shinchan1907/rpmloop-navigator/docs/screenshots/02_home_page1.png

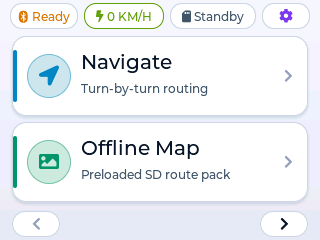
docs/screenshots/02_home_page1.png
