shinchan1907/rpmloop-navigator/docs/screenshots/03_home_page2.png

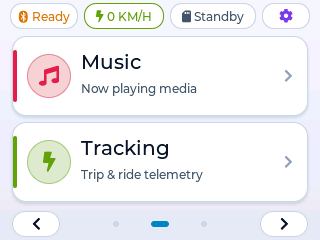
docs/screenshots/03_home_page2.png
