shinchan1907/rpmloop-navigator/docs/screenshots/04_home_page3.png

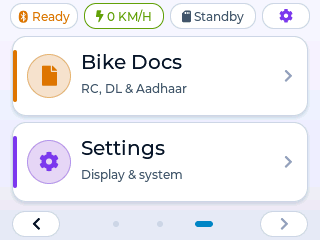
docs/screenshots/04_home_page3.png
