shinchan1907/rpmloop-navigator/docs/screenshots/05_bike_docs_hub.png

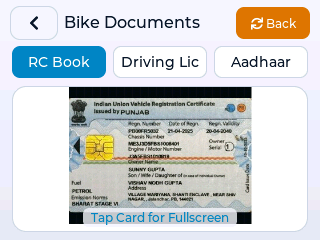
docs/screenshots/05_bike_docs_hub.png
