shinchan1907/rpmloop-navigator/docs/screenshots/06_rc_fullscreen.png

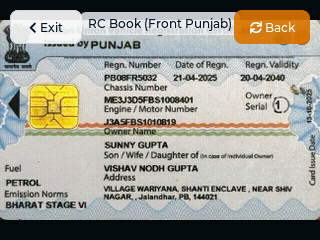
docs/screenshots/06_rc_fullscreen.png
