shinchan1907/rpmloop-navigator/docs/screenshots/07_rc_back_fullscreen.png

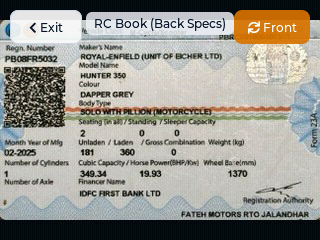
docs/screenshots/07_rc_back_fullscreen.png
