shinchan1907/rpmloop-navigator/docs/screenshots/08_aadhaar_fullscreen.png

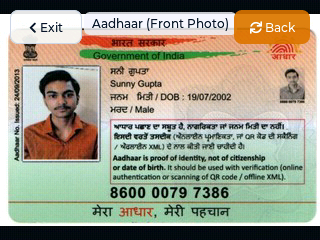
docs/screenshots/08_aadhaar_fullscreen.png
