shinchan1907/rpmloop-navigator/docs/screenshots/09_settings.png

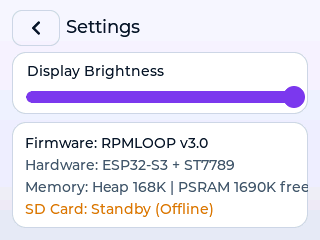
docs/screenshots/09_settings.png
