shinchan1907/rpmloop-navigator/printing_files/parts_and_hardware.csv

part | quantity | file | material | colour | layer_mm | walls | infill | thickness_notes | status
housing | 1 | 01_Rigid_STL/housing_qty1.stl | ASA | matte black | 0.20 | 6 | 35% gyroid, solid mount modifier | 3 mm walls; 4.5 mm seal lands; 3 mm fork fingers | FIT_TEST_ONLY
front_bezel | 1 | 01_Rigid_STL/front_bezel_qty1.stl | ASA | matte black | 0.16-0.20 | 5 | 35% | 4 mm plate | FIT_TEST_ONLY
rear_lid | 1 | 01_Rigid_STL/rear_lid_qty1.stl | ASA | matte black | 0.20 | 5 | 35% | 3 mm plate | FIT_TEST_ONLY
esp32_cradle | 1 | 01_Rigid_STL/esp32_cradle_qty1.stl | ASA | matte black | 0.16 | 4 | 100% | 1.6 mm base; provisional 1.4 mm slide groove | FIT_TEST_ONLY
PCB_tab_left | 2 | 01_Rigid_STL/PCB_tab_left_qty2.stl | ASA | matte black | 0.16-0.20 | 4 | 100% | 2 mm | FIT_TEST_ONLY
PCB_tab_right | 2 | 01_Rigid_STL/PCB_tab_right_qty2.stl | ASA | matte black | 0.16-0.20 | 4 | 100% | 2 mm | FIT_TEST_ONLY
insert_test_coupon | 1 | 01_Rigid_STL/insert_test_coupon_qty1.stl | ASA, same process as housing | matte black | 0.20 | 5 | 100% | 7 mm; four blind pilot trials | FIT_TEST_ONLY
joint_gasket | 2 | 02_Flexible_Prototype_STL/joint_gasket_qty2.stl | Silicone 40-50A preferred; TPU85A fit prototype | black | 0.10-0.15 for TPU | solid | 100% | 1.5 mm uncompressed, 1.3 mm ring width | FIT_TEST_ONLY
display_gasket | 1 | 02_Flexible_Prototype_STL/display_gasket_qty1.stl | Silicone; TPU85A template only | black | 0.10-0.15 for TPU | solid | 100% | 0.8 mm UNVERIFIED | FIT_TEST_ONLY
USB_cap_gasket | 1 | 02_Flexible_Prototype_STL/USB_cap_gasket_qty1.stl | Silicone; TPU85A optional template | black | 0.10-0.15 for TPU | solid | 100% | 1.0 mm; cap not designed | FIT_TEST_ONLY
M2_sealing_washer | 8 | 02_Flexible_Prototype_STL/M2_sealing_washer_qty8.stl | Purchased silicone preferred; TPU85A prototype | black | 0.10 for TPU | solid | 100% | 0.5 mm uncompressed | FIT_TEST_ONLY
M2x4 brass inserts | 14 | PURCHASE | metal | as supplied |  |  |  | Outside diameter and pilot UNVERIFIED | VERIFY_HARDWARE
M2x6 front screw candidates | 4 | PURCHASE | metal | as supplied |  |  |  | Verify head/washer/engagement | VERIFY_HARDWARE
M2x5 screw candidates | 10 | PURCHASE | metal | as supplied |  |  |  | 4 rear + 4 tabs + 2 cradle; verify actual hardware | VERIFY_HARDWARE
M5 thumb screw and mating nut receiver | 1 | PURCHASE | metal | as supplied |  |  |  | Knob opposite USB; actual mount UNVERIFIED | VERIFY_HARDWARE
