shinchan1907/rpmloop-navigator/printing_files/04_CAD/rpmloop_Hunter350_P3_assembly.step

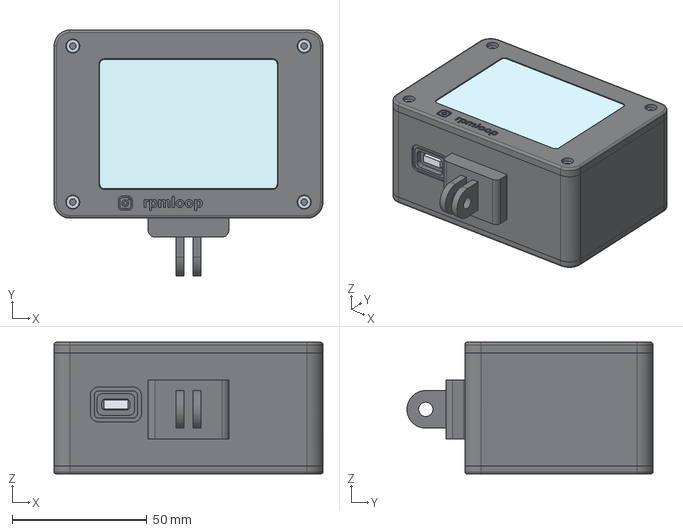
[picture p17: CAD file, 2026-10-26]
printing_files/04_CAD/rpmloop_Hunter350_P3_assembly.step
100.0 x 91.5 x 49.0 mm
