shinchan1907/rpmloop-navigator/printing_files/01_Rigid_STL/front_bezel_qty1.stl

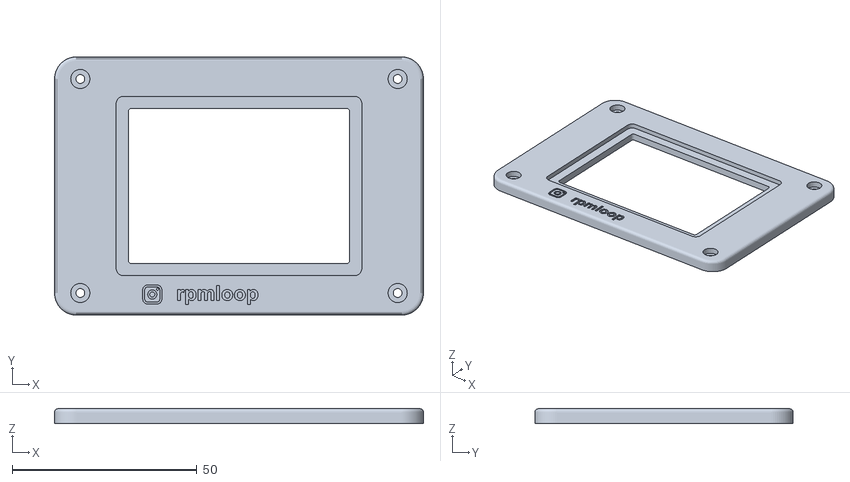
[picture p18: CAD file, 2026-10-26]
printing_files/01_Rigid_STL/front_bezel_qty1.stl
100.0 x 70.0 x 4.00
