shinchan1907/rpmloop-navigator/printing_files/02_Flexible_Prototype_STL/display_gasket_qty1.stl

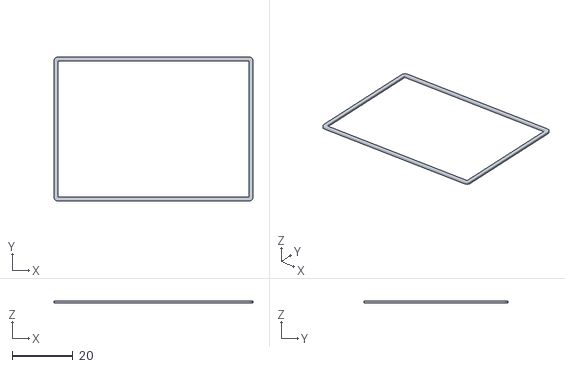
[picture p19: CAD file, 2026-10-26]
printing_files/02_Flexible_Prototype_STL/display_gasket_qty1.stl
65.4 x 47.4 x 0.8
