shinchan1907/rpmloop-navigator/printing_files/04_CAD/housing.step

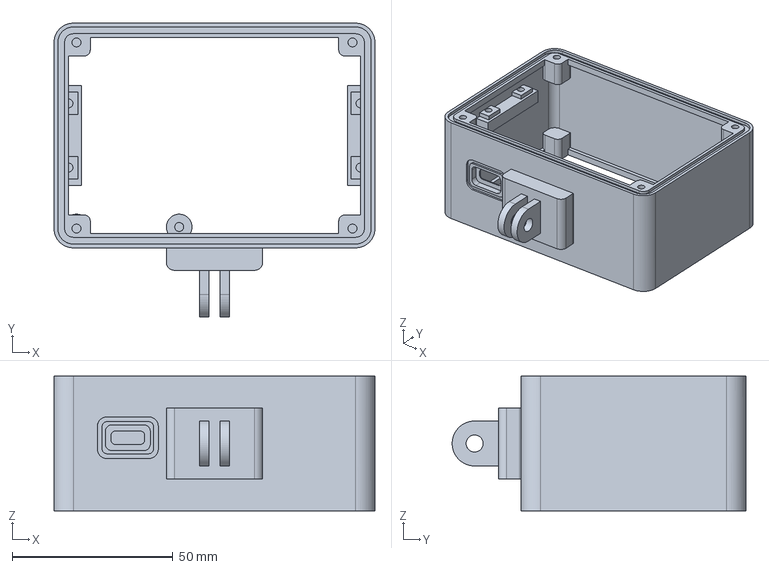
[picture p20: CAD file, 2026-10-26]
printing_files/04_CAD/housing.step
100.0 x 91.5 x 42.0 mm
