shinchan1907/rpmloop-navigator/printing_files/01_Rigid_STL/PCB_tab_right_qty2.stl

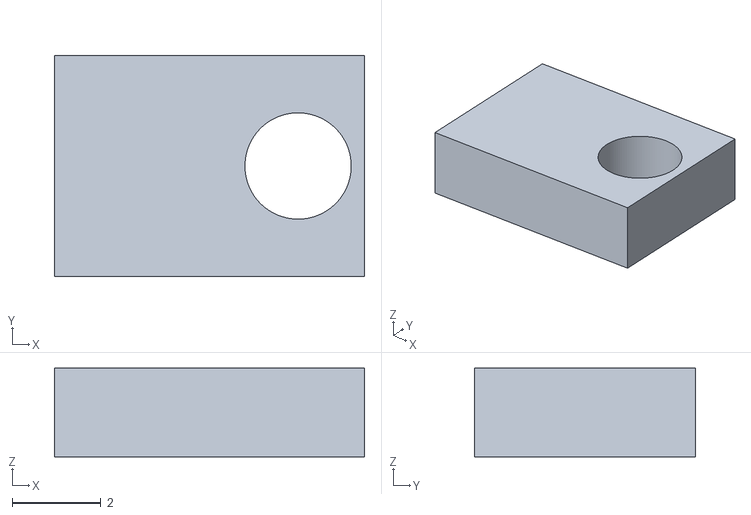
[picture p21: CAD file, 2026-10-26]
printing_files/01_Rigid_STL/PCB_tab_right_qty2.stl
7.00 x 5.00 x 2.00
