shinchan1907/rpmloop-navigator/printing_files/02_Flexible_Prototype_STL/joint_gasket_qty2.stl

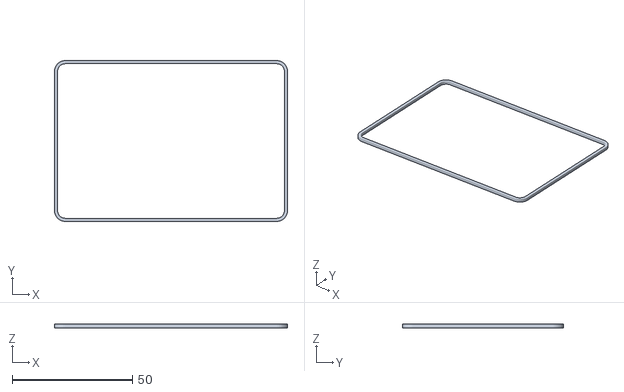
[picture p22: CAD file, 2026-10-26]
printing_files/02_Flexible_Prototype_STL/joint_gasket_qty2.stl
96.8 x 66.8 x 1.50
