shinchan1907/rpmloop-navigator/printing_files/04_CAD/esp32_cradle.step

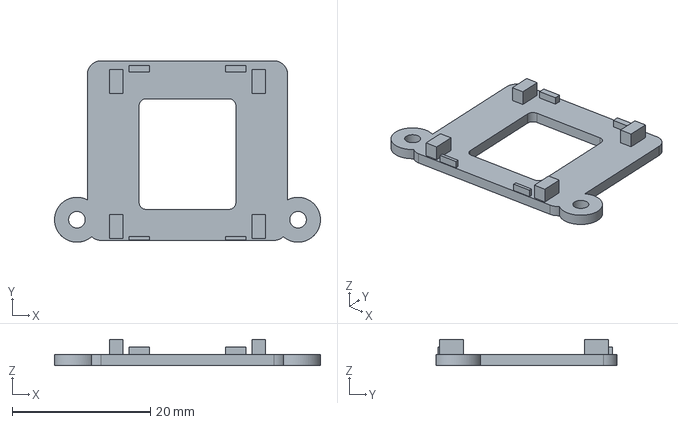
[picture p23: CAD file, 2026-10-26]
printing_files/04_CAD/esp32_cradle.step
38.5 x 26.2 x 3.80 mm
