shinchan1907/rpmloop-navigator/printing_files/01_Rigid_STL/rear_lid_qty1.stl

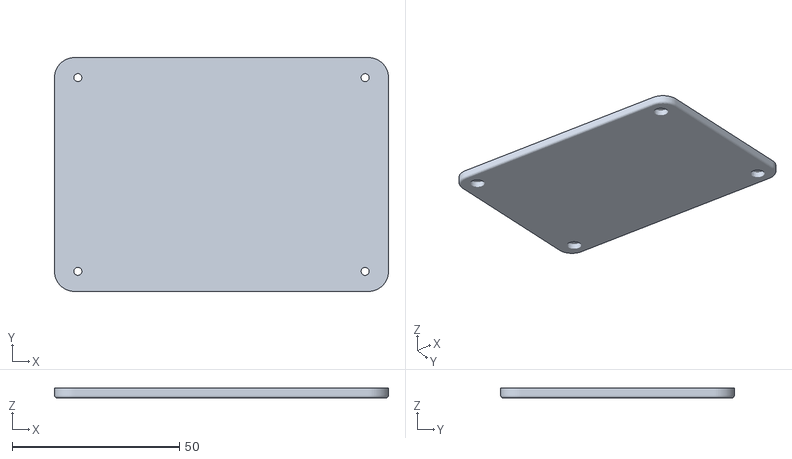
[picture p24: CAD file, 2026-10-26]
printing_files/01_Rigid_STL/rear_lid_qty1.stl
100.0 x 70.0 x 3.00
