shinchan1907/rpmloop-navigator/printing_files/02_Flexible_Prototype_STL/USB_cap_gasket_qty1.stl

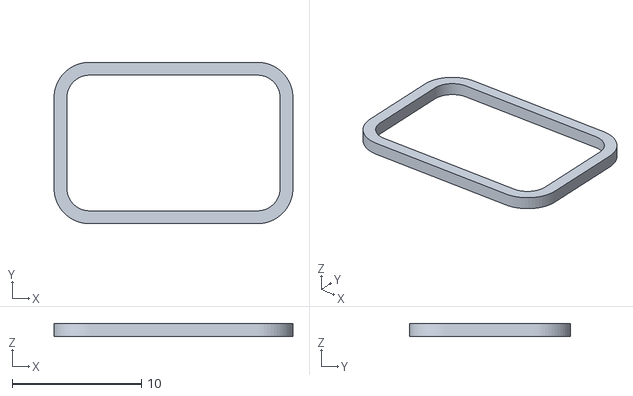
[picture p25: CAD file, 2026-10-26]
printing_files/02_Flexible_Prototype_STL/USB_cap_gasket_qty1.stl
18.5 x 12.5 x 1.00
