shinchan1907/rpmloop-navigator/printing_files/01_Rigid_STL/insert_test_coupon_qty1.stl

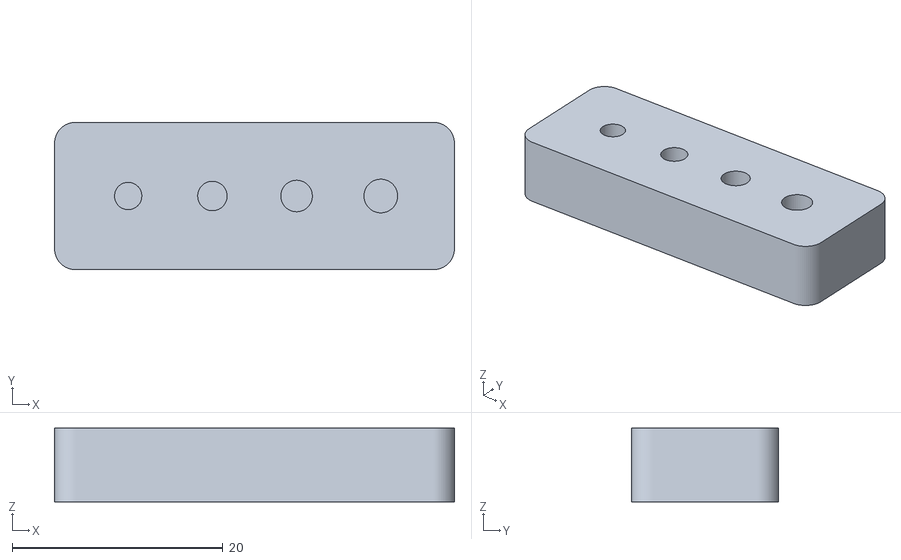
[picture p26: CAD file, 2026-10-26]
printing_files/01_Rigid_STL/insert_test_coupon_qty1.stl
38.0 x 14.0 x 7.00
