shinchan1907/rpmloop-navigator/(list of files, cad)

Other CAD files:
printing_files/01_Rigid_STL/PCB_tab_left_qty2.stl
printing_files/04_CAD/PCB_tab_right.step
printing_files/04_CAD/rear_lid.step
printing_files/04_CAD/front_bezel.step
printing_files/01_Rigid_STL/esp32_cradle_qty1.stl
printing_files/04_CAD/display_gasket.step
printing_files/01_Rigid_STL/housing_qty1.stl
printing_files/04_CAD/PCB_tab_left.step
printing_files/04_CAD/joint_gasket.step
printing_files/04_CAD/insert_test_coupon.step
printing_files/04_CAD/USB_cap_gasket.step
printing_files/02_Flexible_Prototype_STL/M2_sealing_washer_qty8.stl
printing_files/04_CAD/M2_sealing_washer.step
