shinchan1907/rpmloop-navigator/printing_files/03_Images/assembly.png

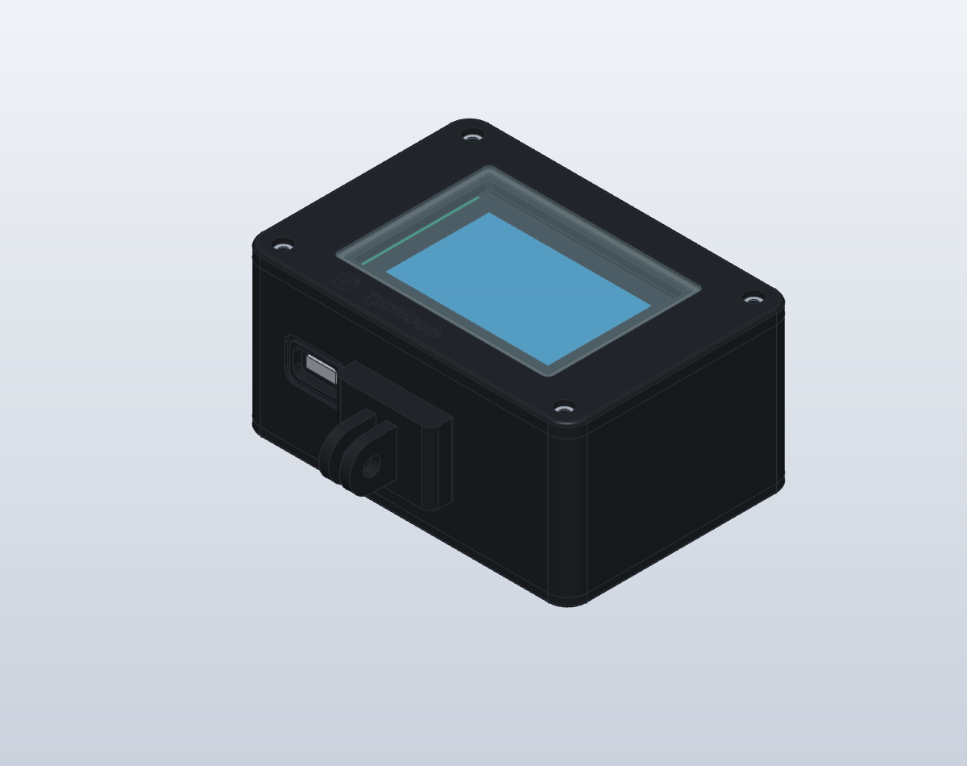
printing_files/03_Images/assembly.png
