shinchan1907/rpmloop-navigator/printing_files/03_Images/bottom_USB_and_two_fingers.png

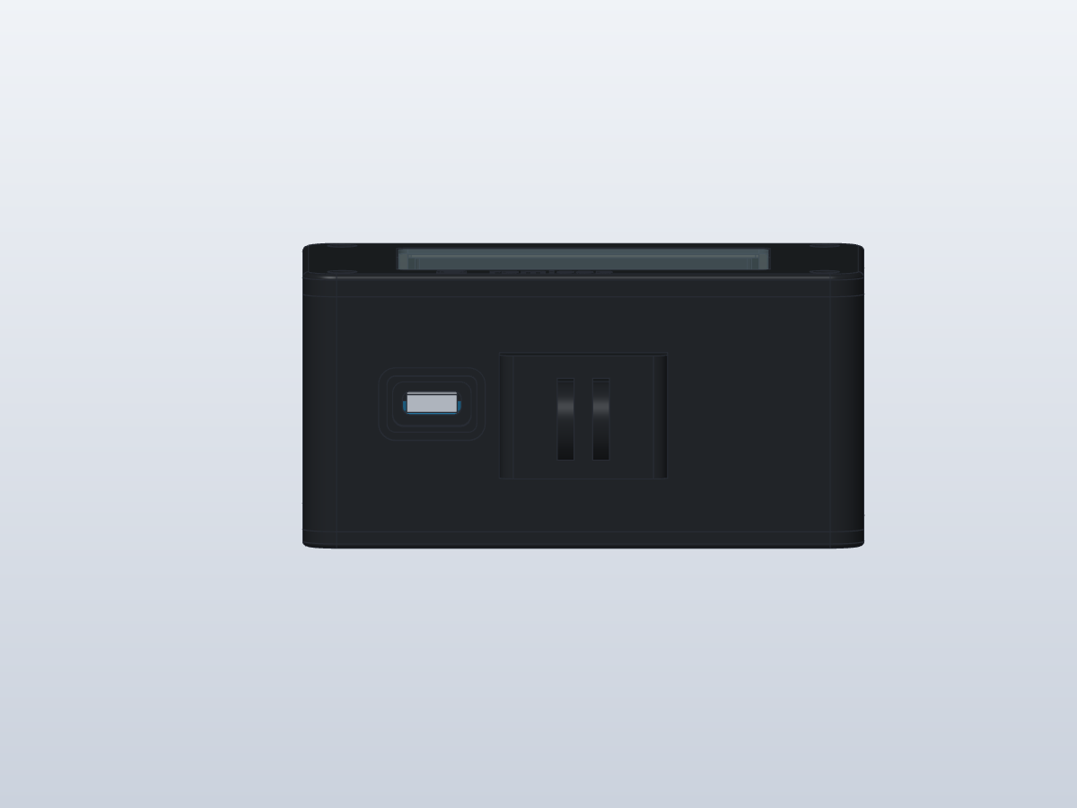
printing_files/03_Images/bottom_USB_and_two_fingers.png
