shinchan1907/rpmloop-navigator/printing_files/03_Images/display_gasket.png

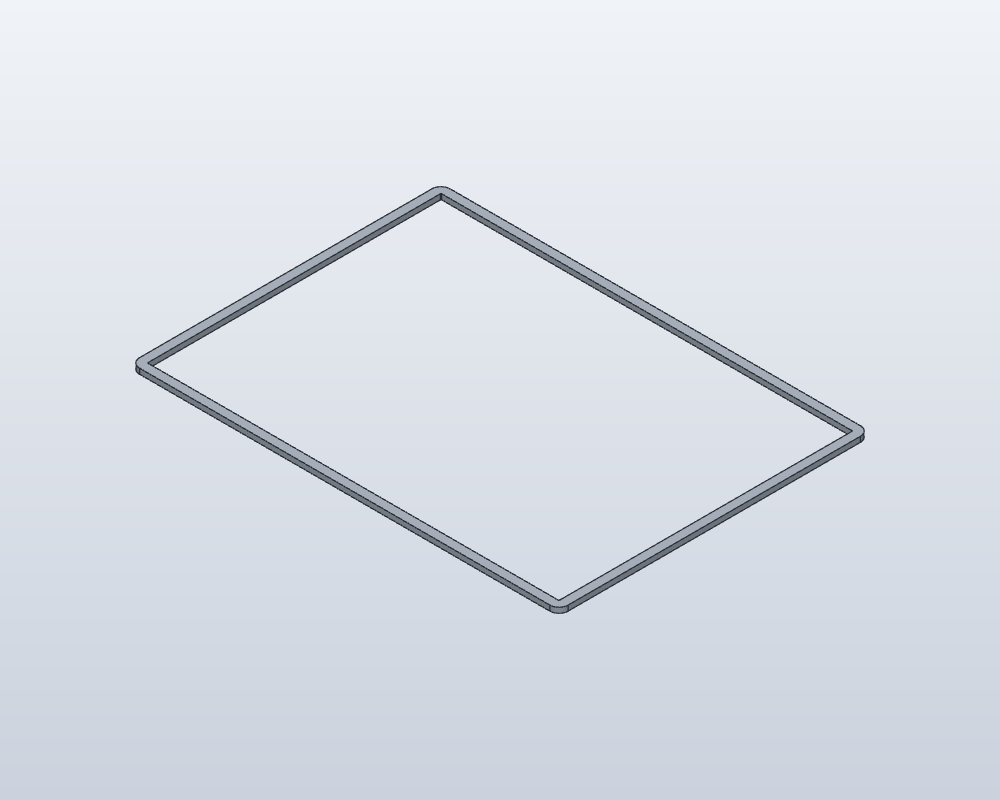
printing_files/03_Images/display_gasket.png
