shinchan1907/rpmloop-navigator/printing_files/03_Images/esp32_cradle.png

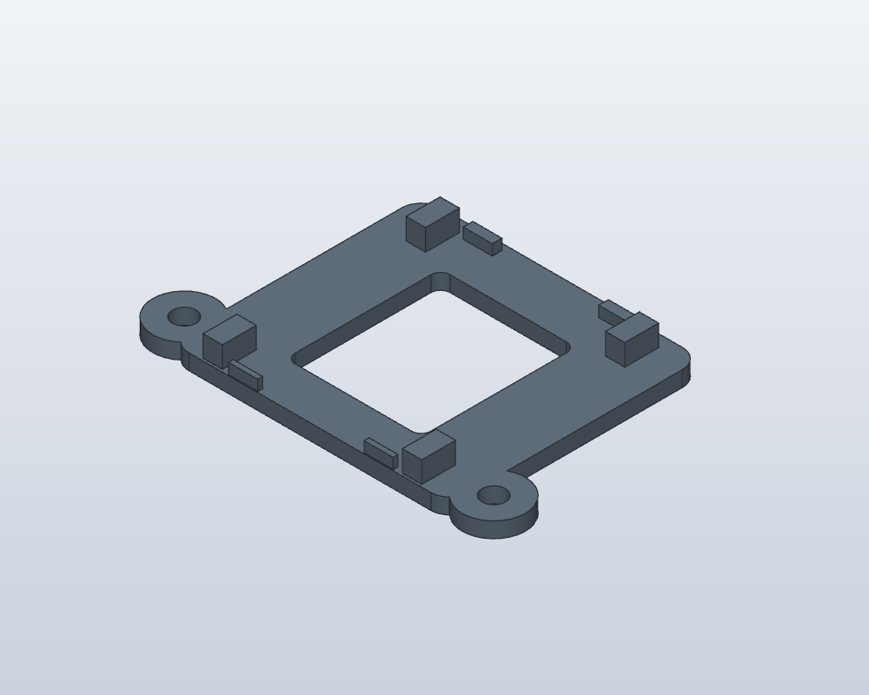
printing_files/03_Images/esp32_cradle.png
