shinchan1907/rpmloop-navigator/printing_files/03_Images/front_bezel.png

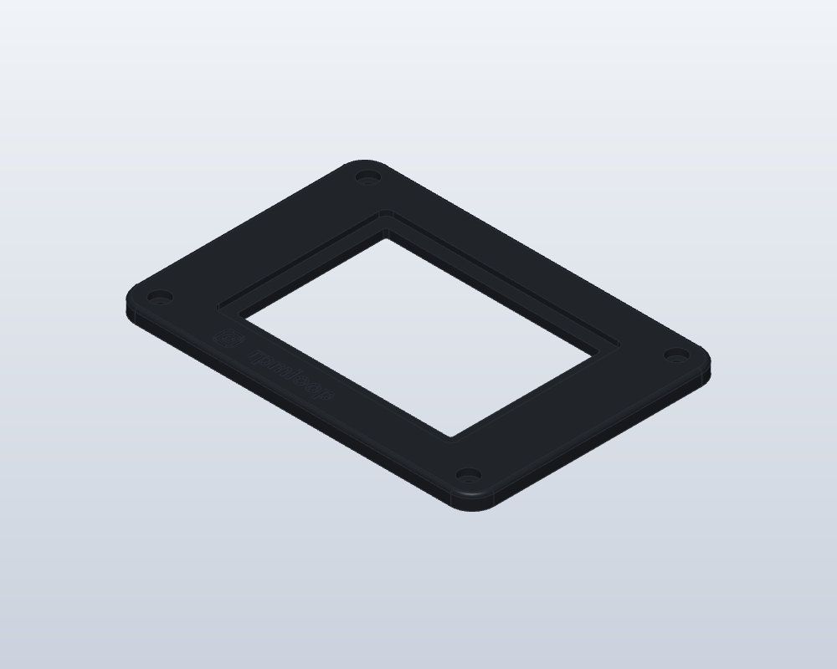
printing_files/03_Images/front_bezel.png
