shinchan1907/rpmloop-navigator/printing_files/03_Images/housing.png

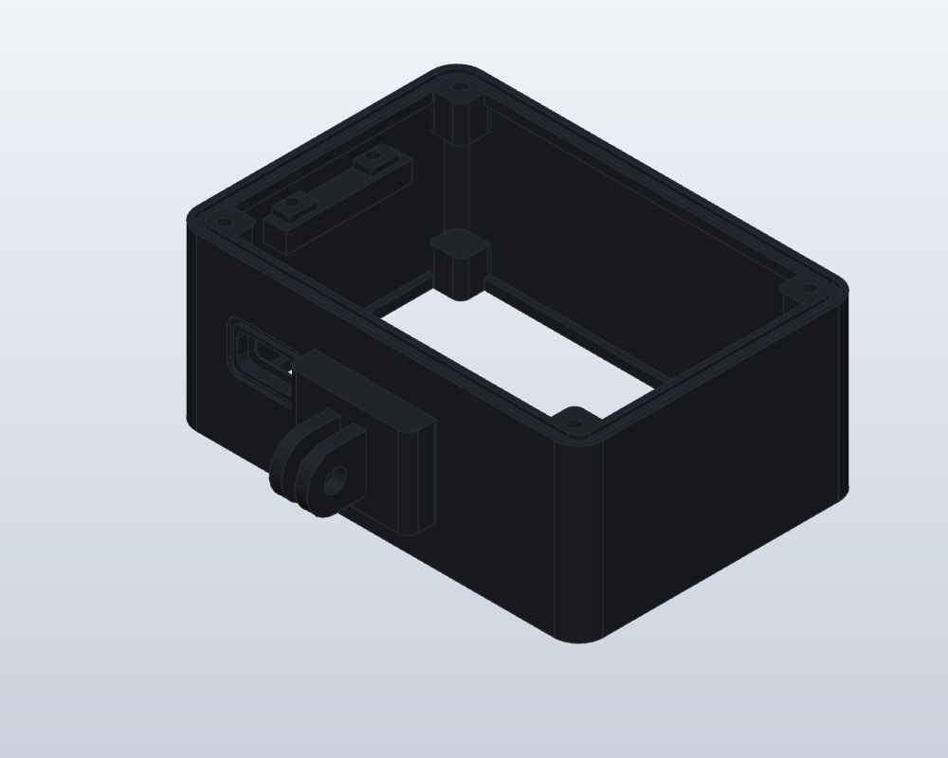
printing_files/03_Images/housing.png
