shinchan1907/rpmloop-navigator/printing_files/03_Images/internal_holders_and_groove.png

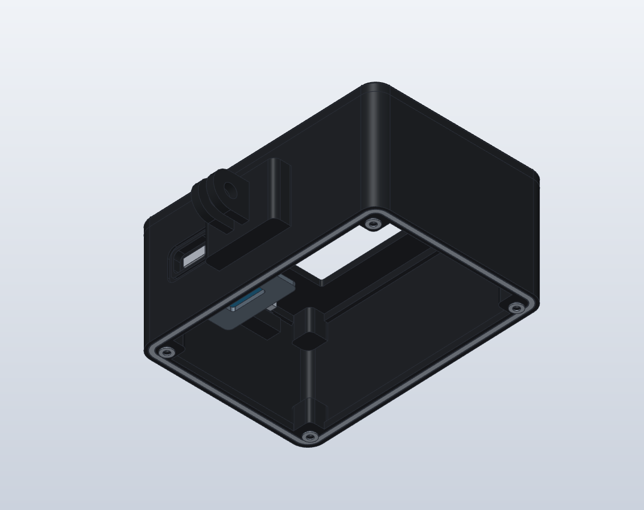
printing_files/03_Images/internal_holders_and_groove.png
