shinchan1907/rpmloop-navigator/printing_files/03_Images/M2_sealing_washer.png

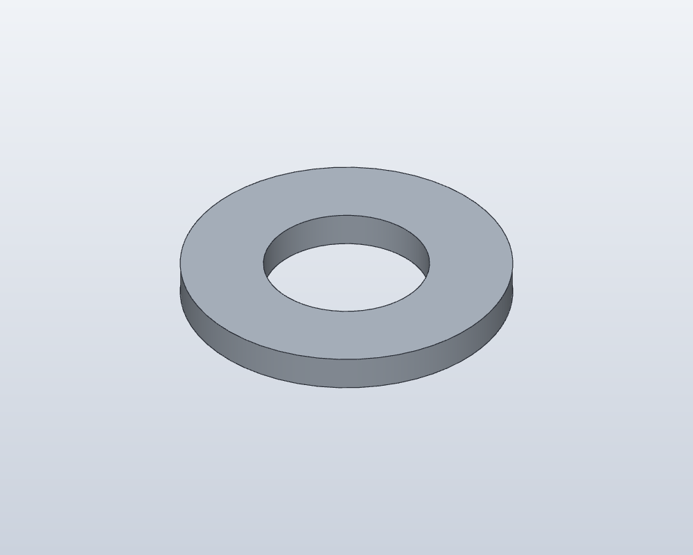
printing_files/03_Images/M2_sealing_washer.png
