shinchan1907/rpmloop-navigator/printing_files/03_Images/PCB_tab_left.png

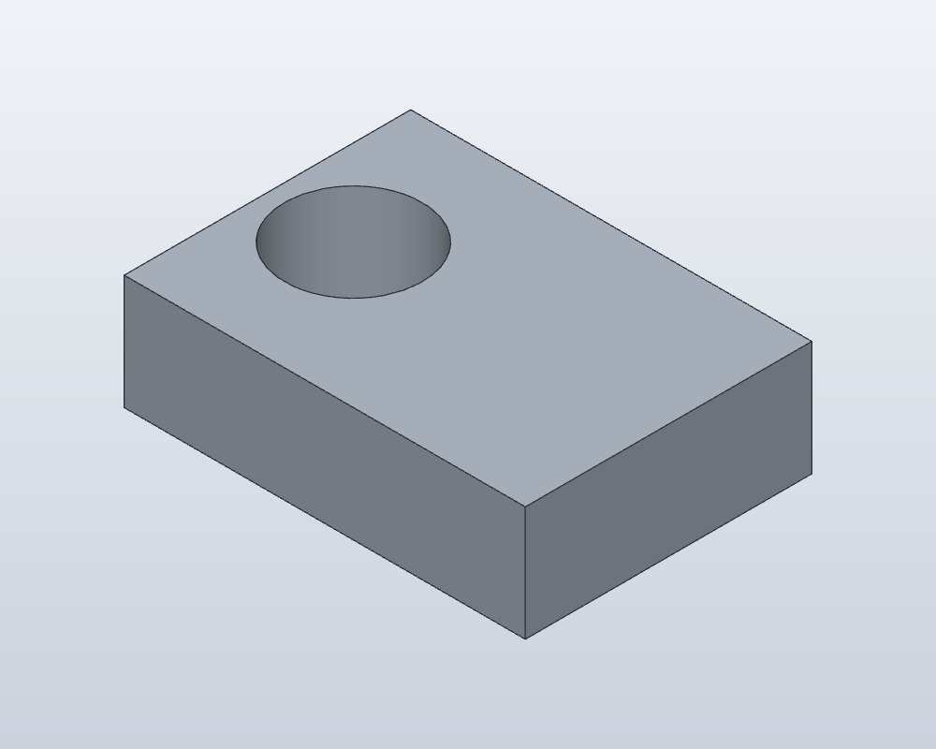
printing_files/03_Images/PCB_tab_left.png
