shinchan1907/rpmloop-navigator/printing_files/03_Images/PCB_tab_right.png

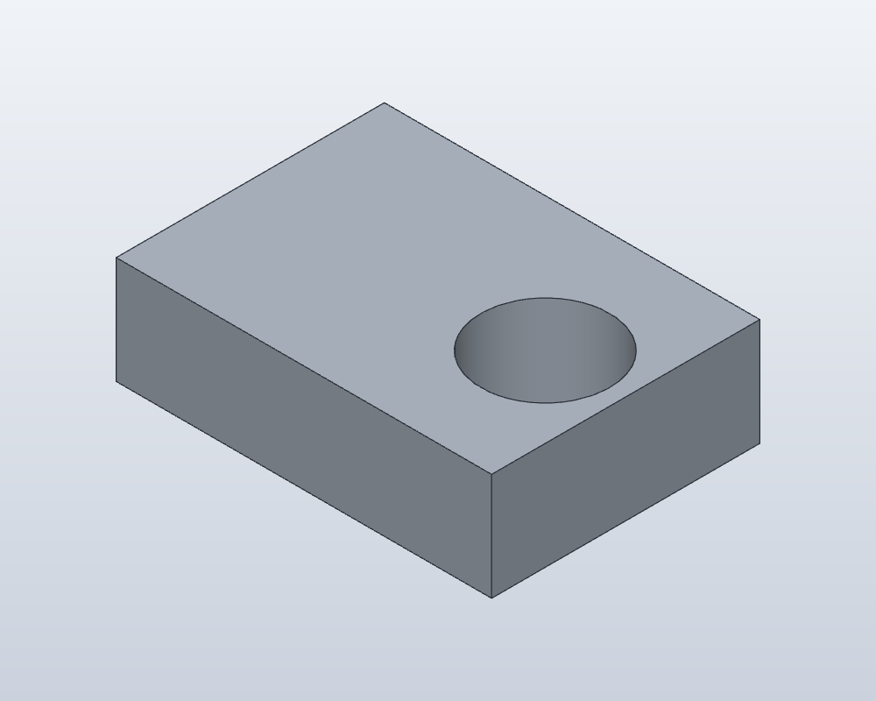
printing_files/03_Images/PCB_tab_right.png
