shinchan1907/rpmloop-navigator/printing_files/03_Images/rear_lid.png

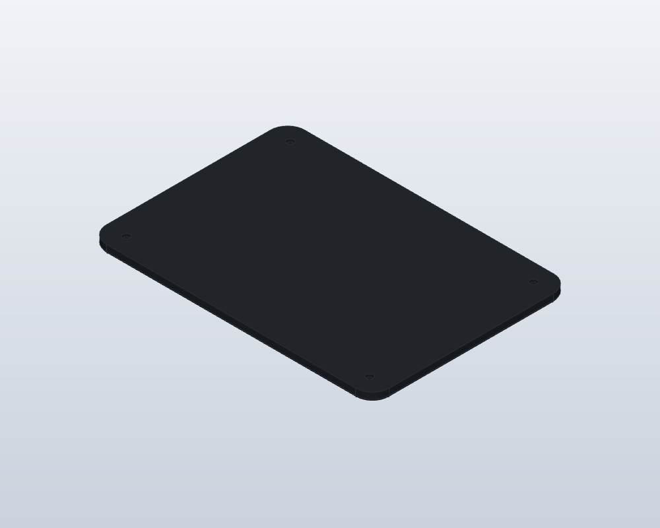
printing_files/03_Images/rear_lid.png
