shinchan1907/rpmloop-navigator/printing_files/03_Images/TOP_RPMLOOP.png

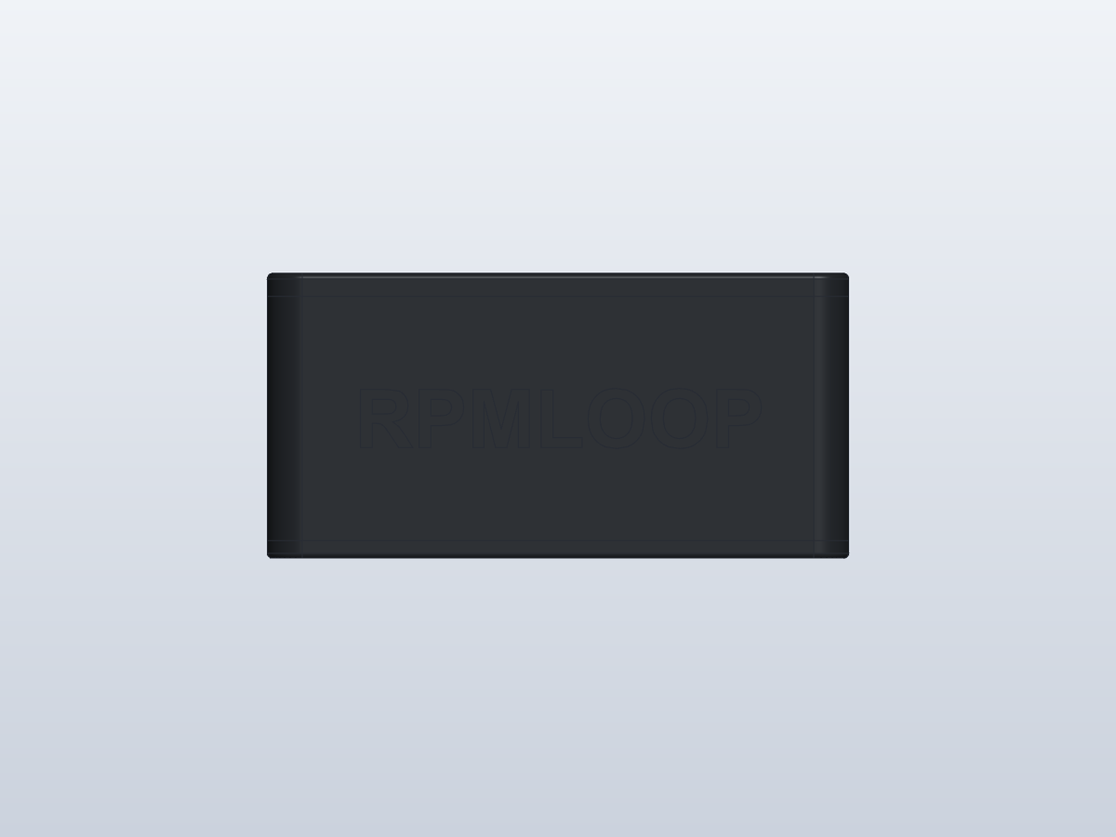
printing_files/03_Images/TOP_RPMLOOP.png
