shinchan1907/rpmloop-navigator/printing_files/03_Images/USB_cap_gasket.png

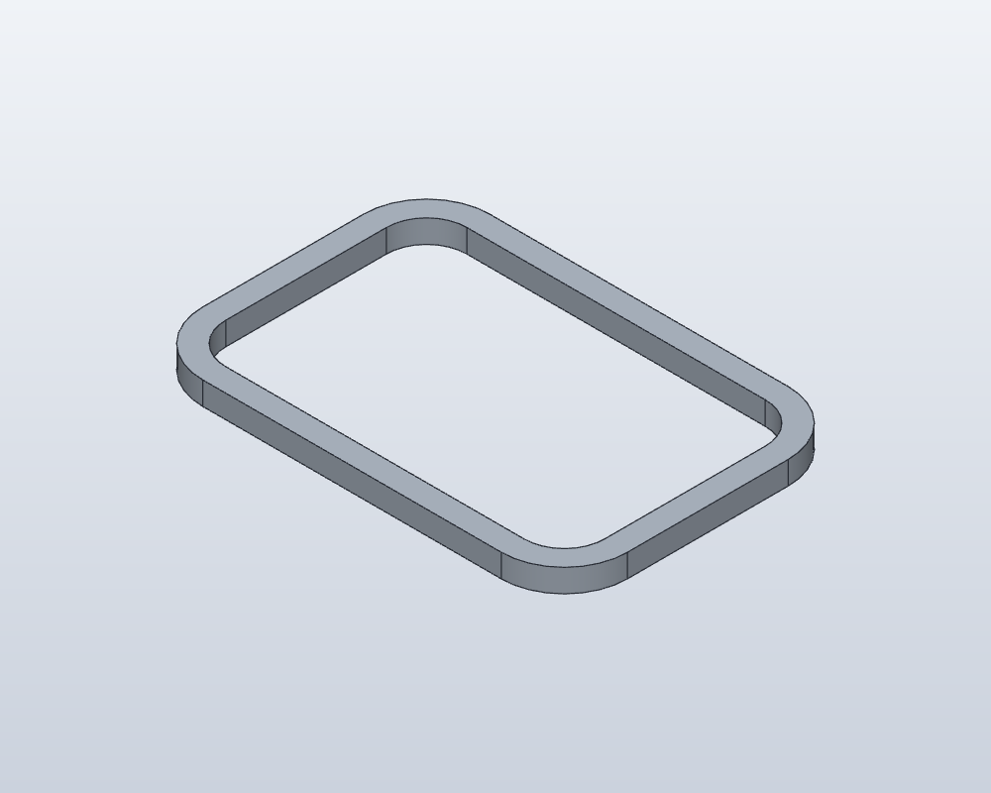
printing_files/03_Images/USB_cap_gasket.png
