shinchan1907/rpmloop-navigator/printing_files/03_Images/insert_test_coupon.png

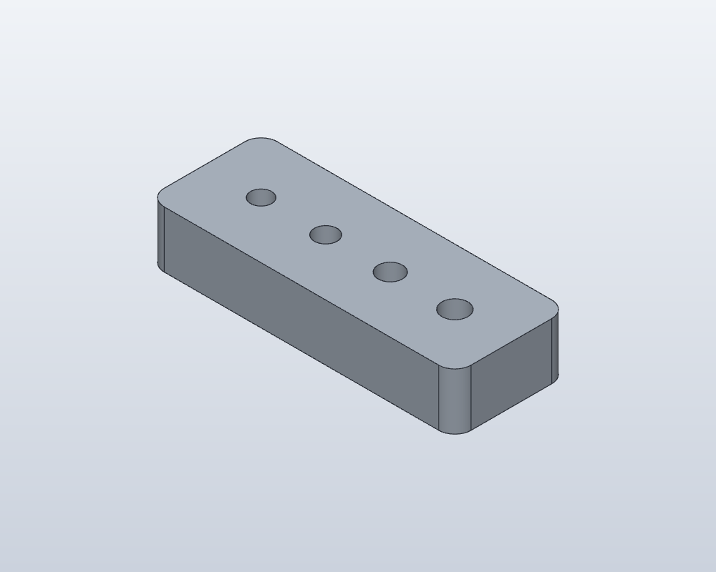
printing_files/03_Images/insert_test_coupon.png
