shinchan1907/rpmloop-navigator/(commit log)

2026-10-26 Publish RPMLOOP Navigator P3 hardware and product renders
    [M2_sealing_washer.step, M2_sealing_washer_qty8.stl, PCB_tab_left.step, PCB_tab_left_qty2.stl, PCB_tab_right.step, PCB_tab_right_qty2.stl, USB_cap_gasket.step, USB_cap_gasket_qty1.stl]
2026-10-26 Preserve manufacturing file bytes across platforms
    [parts_and_hardware.csv]
2026-10-27 Add interactive display mockup and map-based Blender renders
    [rpmloop_map_studio.blend]
2026-10-29 feat(firmware): production firmware 2.1.0 — bench-verified ILI9341 config, protocol fixes, embedded LVGL UI
    Bench pinout/panel config (SCLK6/MOSI7/MISO8/CS9/DC10/RST11, invert=true, SPI 16 MHz, rotation 5), BLE protocol ACK fixes, full LovyanGFX + LVGL 8.3.11 embedded UI (8 screens, BikeState + MockProvider, procedural MapView), firmware docs, and first-compile build fixes.
    pio run: SUCCESS — RAM 158,276/327,680 B (48.3%), Flash 1,479,283/6,553,600 B (22.6%).
2026-10-29 feat(firmware): HR2046 touch input, remove legacy encoder/GPS/SD scaffolding (2.2.0)
    Product hardware is now ESP32-S3 + the 2.8in ILI9341 TOUCH display only: Touch_XPT2046 on the shared SPI bus (T_CS=12, T_IRQ=13) drives a single LVGL pointer indev; encoder/keypad indevs and GPS/SD/button pin defines removed; screens converted to touch (click handlers, +/- zoom buttons, map drag-pan); docs aligned.
    pio run: SUCCESS — RAM 157,636/327,680 B (48.1%), Flash 1,479,683/6,553,600 B (22.6%). Touch calibration presets (200-3900) are unverified — on-device calibration pending.
2026-10-29 fix(firmware): match touch wiring to bench — separate SPI pins 1/2/3/5, IRQ unused (2.2.1)
    Touch_XPT2046 now runs on its own SPI3 bus (T_CLK=1, T_DIN=2, T_DO=3, T_CS=5, pin_int=-1 polling) instead of the assumed shared display bus — in LovyanGFX, reusing SPI2_HOST with different pins would silently keep the display pin routing. pio run: SUCCESS — RAM 157,636/327,680 B (48.1%), Flash 1,479,683/6,553,600 B (22.6%).
2026-10-29 fix(firmware): support 4MB flash dev board in production hardware env
2026-10-29 feat(firmware): ST7789V panel driver, 4MB-only target, TomTom-style Nav UI (2.2.2)
    Panel is ST7789V (chip ID probed on hardware: 0x85 0x85 0x52), not ILI9341: Panel_ST7789, invert=false, rotation=1. Build target locked to the 4MB ESP32-S3 Mini. Nav screen rebuilt to the reference layout: full-screen 2D map (river, buildings, blue route), two-segment top banner with Then chip, speed-limit + speed cluster bottom-centre, round buttons on the left edge.
    pio run: SUCCESS — RAM 157,636/327,680 B (48.1%), Flash 1,503,135/4,063,232 B (37.0% of the 4MB app partition).
2026-10-29 fix(firmware): bench-measured touch calibration — ranges 270..3780 / 280..3650, offset_rotation 4 (2.2.3)
    Calibration derived from the bench unit's 5-point stylus measurements (raw values logged on hardware). The touch film is axis-swapped vs the screen — raw X tracks screen Y, raw Y tracks screen X — resolved with touch offset_rotation = 4 so the TOUCH_CAL ranges stay in the driver's own frame. Centre-point cross-check: X error ~5 px, Y within ~14 px.
    pio run: SUCCESS.
2026-10-29 feat(firmware): vibrant UI, animated splash + Connect flow, demo mode OFF by default (2.3.0)
    Owner-directed redesign: deep navy gradient theme with neon cards (lime/cyan/pink/amber); animated RPM LOOP splash (~3.5 s) -> Connect screen with radiating Bluetooth rings on tap -> Home when the phone links; disconnect returns to Connect. No more fabricated data — MockProvider is gated behind a new Demo mode switch in Settings (default OFF) and every screen has honest empty states; Nav shows a 'No active route' pill when idle.
    pio run: SUCCESS — RAM 157,788/327,680 B (48.2%), Flash 1,511,627/4,063,232 B (37.2%).
2026-10-29 feat(firmware): 2.4.0 UI overhaul — wallpaper, full-bleed layouts, swipe-down quick shade, splash v2, headset screen removed
    Owner-directed: generated sky-blue/neon-lime wallpaper baked in as a 320x240 RGB565 asset behind Boot/Connect/Home/Music/Tracking/Settings; full-bleed layouts (Home tiles end ~y204 + real-state status strip, no more dead gradient); swipe-down quick shade on every screen (pull handle + gesture; transparent top strip on map screens) with big HOME button, brightness slider, BT status and a Settings shortcut; splash v2 with popping letters, RPM gauge sweep + needle and % counter. Headset screen REMOVED — the headset pairs with the phone only, never with this device.
    p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
2026-10-29 fix(firmware): quick shade trigger — tappable pull zone + release-fired drag strip (2.4.2)
    On-device report: the swipe-down quick shade never opened and no Home button was reachable from Nav. Root cause: the plain-screen trigger relied on LV_EVENT_GESTURE, but lv_indev zeroes its gesture sum whenever the per-read velocity dips below the minimum, so a slow drag on the polled resistive touch never accumulates the 50 px a gesture needs; bubbling was also only set on direct children. Fix: the pull pill is now a real clickable 64x20 zone — a TAP opens the shade, and so does a short downward drag (manual PRESSED/PRESSING/RELEASED detection, 28 px). The Nav/Maps top strip keeps its drag detecti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
2026-11-02 chore: reset repo for from-scratch rebuild — remove all code, keep printing_files only
    Owner direction (2026-11-02): wipe the entire codebase (firmware, companion apps, simulator, docs, rendering) and rebuild RPMLOOP from scratch — fresh firmware, fresh UI, fresh logic, interrupt-driven touch via T_IRQ on GPIO4. Only printing_files/ (Hunter 350 enclosure print package) is retained, plus a new README recording the verified hardware and pin map. All removed code remains recoverable from git history (last old-code commit 8398831, firmware 2.4.2).
    [rpmloop_map_studio.blend, rpmloop_studio.blend]
2026-11-02 docs: README — SD module wired (CS GPIO13, shared SPI bus), SD-preload architecture
    The owner wired the separate SPI microSD module to the ESP (2026-11-02) and confirmed it done: VCC 5V (module regulator), SCK/MOSI/MISO shared with the display bus on GPIO 6/7/8, CS GPIO13. The map architecture is therefore SD-preload — tiles live on the card in tiles/{z}/{x}/{y}.jpg layout and render directly; the companion app sends only GPS/nav/media data. README's pin table and SD note updated to match; the earlier 'no SD in this build' line is superseded.
2026-11-02 feat(companion_app): Android companion Phase 1 — BLE handshake + GPS streaming
    Kotlin app (minSdk 26, targetSdk 34): scan/connect to RPMLOOP, MTU 512, protocol v3.0.0 hello handshake, FusedLocation ~1 Hz position JSON gated on hello_ack, foreground location service, honest status UI. Phase 2 (Maps-notification nav, polyline, media session, tracking) = marked stubs, no fake data. Not yet compiler-verified (no Android SDK on the build VM) — first build in Android Studio.
2026-11-03 fix(firmware): repairs on v3.0 rebuild — compiles, format path removed, SD fast bus
    testRawSD pin getters fixed (pushed tree did not compile); formatCard() + CMD:SD_FORMAT removed; SD restored to dedicated SPIClass, 4 MHz mount + 400 kHz fallback. Verified: pio run SUCCESS, RAM 36860 B, Flash 1227759 B. Embedded documents left as-is (owner's call).
2026-11-03 feat(firmware): Bike Docs are SD-only — embedded documents removed
    Owner's decision: documents belong on the attached microSD card, never inside the ESP firmware. Removed docs_data.h / aadhaar_data.h and the in-flash fallback in loadDocJpeg; Docs load only from /docs/ on the card. Verified: pio run SUCCESS, RAM 36860 B, Flash 1112319 B.
2026-11-03 feat(firmware): Royal Enfield boot splash + premium light UI redesign
    Boot flow: RE logo (owner-supplied art, white wordmark on the Instagram gradient — owner's pick) fades in 700 ms, fades out at 3.1 s, hands over at 3.85 s; RPMLOOP splash then runs a full 4.5 s. Light UI rebuilt: gradient pages, soft-shadow white cards, tinted chips/pills, paged home with manual swipe restored. Verified: pio run SUCCESS, RAM 36900 B, Flash 1123943 B.
2026-11-03 feat(firmware): BLE file receiver — protocol v3.1 (tiles phone -> SD card)
    New file_receiver module + FILE_DATA/FILE_CTRL characteristics: the phone writes map tiles onto the device microSD at /tiles/{z}/{x}/{y}.jpg with seq-checked chunks, 16-chunk acks, durable resume via .part files, and size-verified rename on completion. Verified: pio run SUCCESS, RAM 37204 B, Flash 1128071 B.
2026-11-03 feat(companion_app): full version — turn-by-turn navigation + offline tiles
    Navigation: Nominatim search, waypoints, OSRM routing, in-service nav engine (reroute + arrival) streaming polyline/nav to the device, screen-off safe. Tiles: route/area packs via the Google Tile API (user key in Settings), BLE v3.1 transfer with resume. Media/tracking remain marked stubs. Not compiler-verified (no Android SDK on VM).
2026-11-03 feat: Upgrade to Wireless Android Auto (H.264 video streaming, touch zoom, ST7789V, clean UI)
    [partitions.csv]
2026-11-03 fix: Normal ST7789 colors (invert=false) and sophisticated automotive cockpit UI
    [board.cpp]
